DeepooBelief/BoostPFC/(list of files, cad)

Other CAD files:
software/adc_ex10_multiple_soc_epwm/CPU1_LAUNCHXL_FLASH/DCL_futils.obj
software/adc_ex10_multiple_soc_epwm/CPU1_LAUNCHXL_RAM/adc_ex10_multiple_soc_epwm.obj
software/adc_ex10_multiple_soc_epwm/CPU1_LAUNCHXL_RAM/device/device.obj
software/adc_ex10_multiple_soc_epwm/CPU1_LAUNCHXL_RAM/syscfg/c2000ware_libraries.obj
software/adc_ex10_multiple_soc_epwm/CPU1_RAM/adc_ex10_multiple_soc_epwm.obj
software/adc_ex10_multiple_soc_epwm/CPU1_RAM/syscfg/c2000ware_libraries.obj
software/adc_ex10_multiple_soc_epwm/CPU1_LAUNCHXL_FLASH/DCL_error.obj
software/adc_ex10_multiple_soc_epwm/CPU1_LAUNCHXL_RAM/syscfg/board.obj
software/adc_ex10_multiple_soc_epwm/CPU1_RAM/device/device.obj
software/adc_ex10_multiple_soc_epwm/CPU1_RAM/syscfg/board.obj
software/adc_ex10_multiple_soc_epwm/CPU1_LAUNCHXL_FLASH/DCL_PI_C1.obj
software/adc_ex10_multiple_soc_epwm/CPU1_LAUNCHXL_FLASH/DCL_PI_C7.obj
software/adc_ex10_multiple_soc_epwm/CPU1_LAUNCHXL_FLASH/DCL_PI_C4.obj
software/adc_ex10_multiple_soc_epwm/CPU1_LAUNCHXL_FLASH/DCL_DF23_C1.obj
software/adc_ex10_multiple_soc_epwm/CPU1_LAUNCHXL_FLASH/DCL_DF11_C1.obj
software/adc_ex10_multiple_soc_epwm/CPU1_LAUNCHXL_FLASH/DCL_DF13_C2C3.obj
software/adc_ex10_multiple_soc_epwm/CPU1_LAUNCHXL_FLASH/DCL_DF13_C1.obj
software/adc_ex10_multiple_soc_epwm/CPU1_LAUNCHXL_FLASH/DCL_PID_C4.obj
software/adc_ex10_multiple_soc_epwm/CPU1_LAUNCHXL_FLASH/DCL_clamp_C1.obj
software/adc_ex10_multiple_soc_epwm/CPU1_LAUNCHXL_FLASH/DCL_PID_C1.obj
software/adc_ex10_multiple_soc_epwm/CPU1_LAUNCHXL_FLASH/DCL_DF22_C1.obj
software/adc_ex10_multiple_soc_epwm/CPU1_LAUNCHXL_FLASH/DCL_DF22_C2C3.obj
software/adc_ex10_multiple_soc_epwm/CPU1_LAUNCHXL_FLASH/DCL_DF23_C2C3.obj
software/adc_ex10_multiple_soc_epwm/CPU1_LAUNCHXL_RAM/device/f28002x_codestartbranch.obj
software/adc_ex10_multiple_soc_epwm/CPU1_RAM/device/f28002x_codestartbranch.obj
