DeepooBelief/BoostPFC/hardware/SCH_Schematic1.pdf

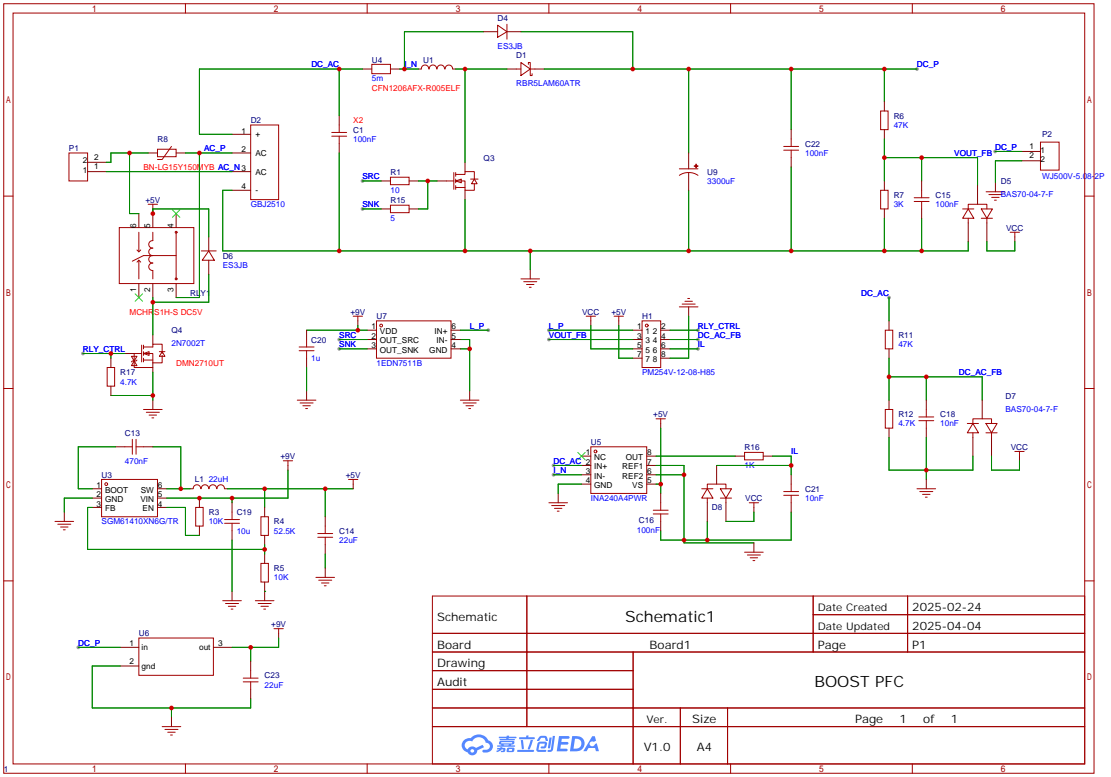
[picture p4: page 1]

Schematic | Schematic1 | Date Created | 2025-02-24

Date Updated | 2025-04-04

Board | Board1 | Page | P1
Drawing | | BOOST PFC
Audit

Ver. | Size | Page 1 of 1
