DeepooBelief/BoostPFC/hardware/PCB_PCB1.pdf

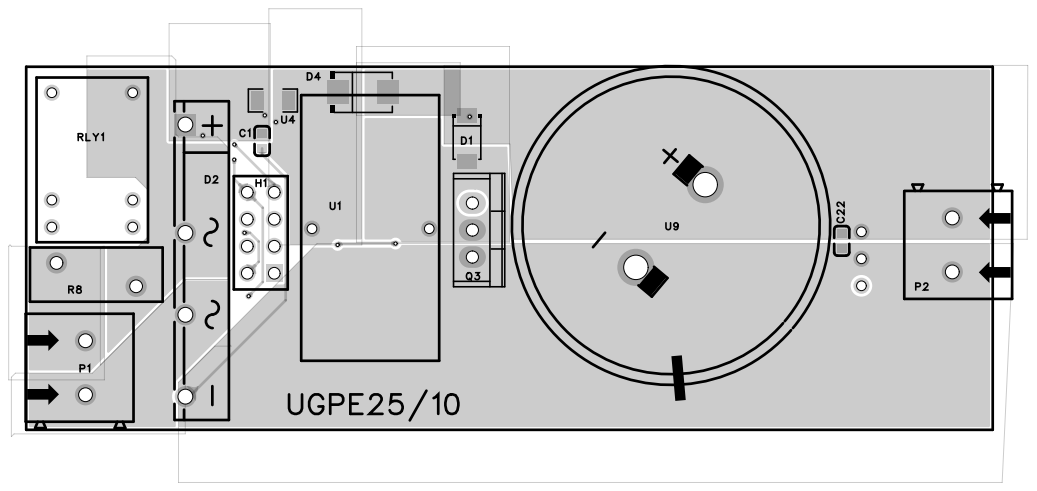
[picture p5: page 1]

RLY1

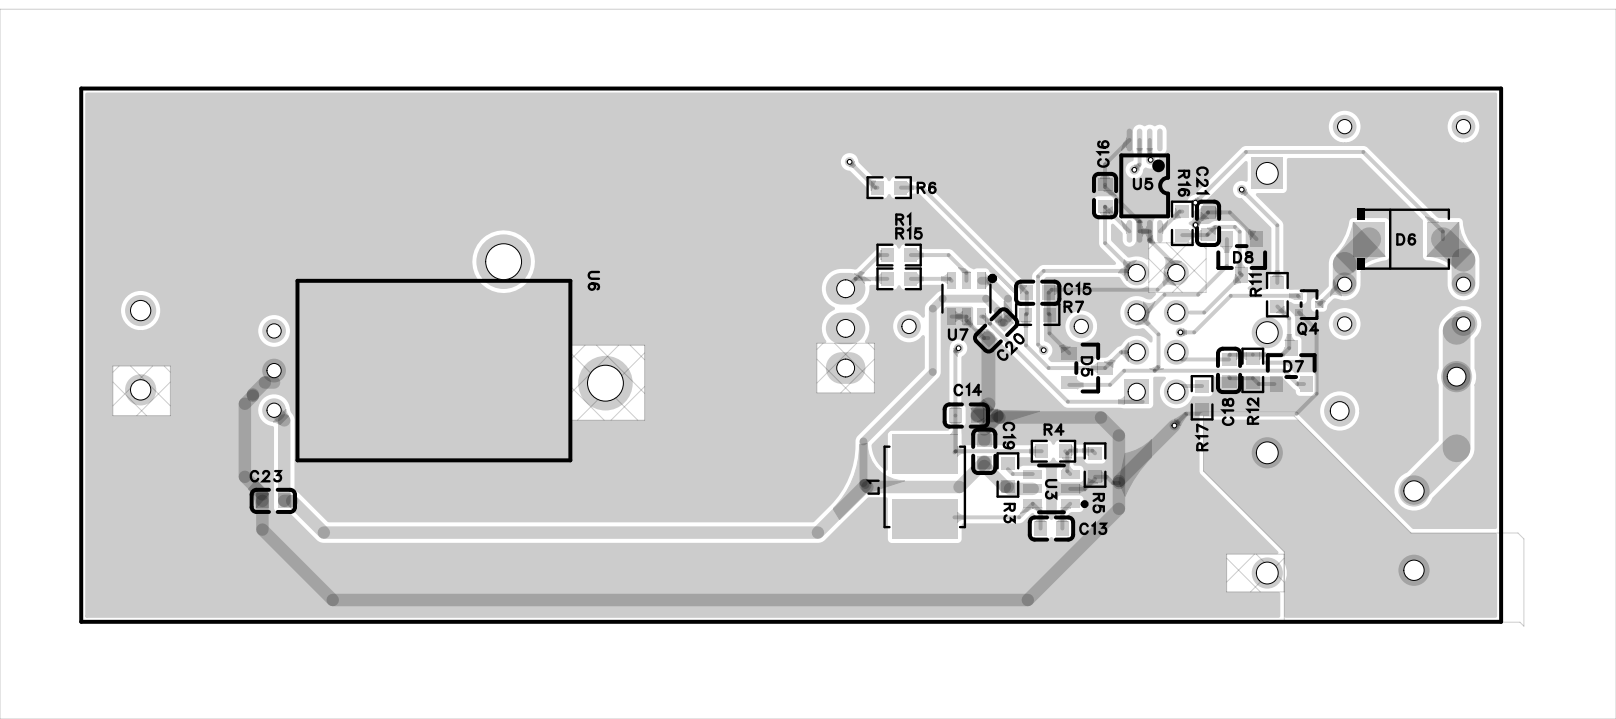
[picture p6: page 2]

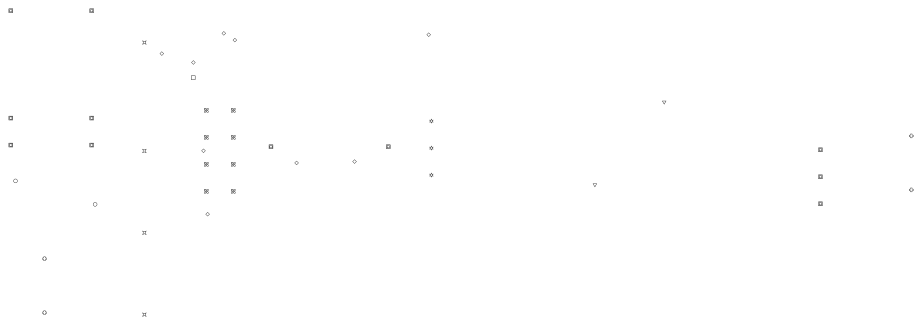
[picture p7: page 3]
