DeepooBelief/BoostPFC/simulation/ltspice/CCM-PFC(Switchless).asc

B1: bv; V=I(L1)
C1: cap; 0.1µ; V=50 Irms=0 Rser=0.07
C2: polcap; 1500µ; V=50 Irms=5.216 Rser=0.0246
C3: polcap; 1500µ; V=50 Irms=5.216 Rser=0.0246
D1: diode; DRBR5LAM60ATF
D2: diode
D3: diode
D4: diode
D5: diode
L1: ind; 470µ; Ipk=3 Rser=0.11 Rpar=9050 Cpar=55.774p
R1: res; 40
U1: UnitDelay; T=2e-5
U2: IPP052N08N5_L0
U3: UnitDelay; T=2e-5
U4: Proportional; K=0.1795
U5: add
U6: Proportional; K=5.6400e-05
U7: add
U8: sub
U9: limit; y=-4 z=4
U10: limit; y=0 z=4
U11: Proportional; K=0.1817
U12: sub
U13: add
U14: Proportional; K=0.0824
U15: mul
U16: add
U17: UnitDelay; T=2e-5
U18: limit; y=-100 z=100
U19: Proportional; K=1/(24*sqrt(2))
U20: limit; y=0 z=1
U21: UnitDelay; T=2e-5
U22: PWM; Vin1=0 Vin2=1 Tperiod=2e-5
U24: mul
V1: voltage; SINE(0 {24*sqrt(2)} 50)
V2: voltage; 10
V3: voltage; 40
Named nets: 0, AC_L, DC_P, AC_N, v*, ia*, DC_AC, m*, il, il*
.tran 0 500m 0 startup
.model SW SW(Ron=1 Roff=1Meg Vt=0.5)
.model D D(Ron=.1 Roff=1Meg Vfwd=.4)
Controller
Circuit
.ic V(DC_P)=0
voltage controller
current controller
Config
CCM-PFC
Continuous Conduction Mode Power Factor Correction
NOTE
Switching elements are approximated
by imaginary variable dc transformers.
This reduces transient analysis time.
Discontinuous conduction mode is NOT considered.
.MODEL DRBR5LAM60ATF D
+ IS=648.10E-9
+ N=.94915
+ RS=16.414E-3
+ IKF=1.8382
+ XTI=2
+ EG=.69
+ CJO=839.22E-12
+ M=.53961
+ VJ=.50407
+ ISR=6.2071E-6
+ NR=1.2000
+ BV=60
+ TRS1=0.0060
