DeepooBelief/BoostPFC/simulation/ltspice/CCM-PFC(Switchless)_REAL.asc

B1: bv; V=I(L1)
C1: cap; 1µ
C2: cap; 3300µ
D2: diode
D3: diode
D4: diode
D5: diode
D6: schottky; RBR20NS60A
L1: ind; 330µ
R1: res; 40
U1: UnitDelay; T=2e-5
U2: PWM; Vin1=0 Vin2=1 Tperiod=2e-5
U3: UnitDelay; T=2e-5
U4: Proportional; K=0.1095
U5: add
U6: Proportional; K=8.6000e-05
U7: add
U8: sub
U9: limit; y=-4 z=4
U10: limit; y=0 z=4
U11: Proportional; K=0.1095
U12: sub
U13: add
U14: Proportional; K=0.0540
U15: mul
U16: add
U17: UnitDelay; T=2e-5
U18: limit; y=-100 z=100
U19: Proportional; K=1/(24*sqrt(2))
U20: limit; y=0 z=1
U21: UnitDelay; T=2e-5
U22: IPA052N08NM5S_L0
U23: mul
V1: voltage; SINE(0 {24*sqrt(2)} 50)
V2: voltage; 10
V3: voltage; 40
Named nets: 0, AC_L, DC_P, AC_N, v*, ia*, DC_AC, m*, il, il*, PWM
.tran 0 500m 0 startup
.model SW SW(Ron=1 Roff=1Meg Vt=0.5)
.model D D(Ron=.1 Roff=1Meg Vfwd=.4)
Controller
Circuit
.ic V(DC_P)=0
voltage controller
current controller
Config
CCM-PFC
Continuous Conduction Mode Power Factor Correction
NOTE
Switching elements are approximated
by imaginary variable dc transformers.
This reduces transient analysis time.
Discontinuous conduction mode is NOT considered.
.MODEL DRBR5LAM60ATF D
+ IS=648.10E-9
+ N=.94915
+ RS=16.414E-3
+ IKF=1.8382
+ XTI=2
+ EG=.69
+ CJO=839.22E-12
+ M=.53961
+ VJ=.50407
+ ISR=6.2071E-6
+ NR=1.2000
+ BV=60
+ TRS1=0.0060
