DeepooBelief/BoostPFC/simulation/ltspice/DCDCboost_Ideal.asc

C1: cap; 3.3m
D1: diode
I1: current; {Iout}
L1: ind; 330µ
S1: sw
V1: voltage; {Vsupp}
V2: voltage; PULSE(0 9 0 0.000000008 0.000000008 {duty*0.00002} 0.00002)
Named nets: 0, PWM, Vout, Vin
.MODEL SW SW(Ron=0.0001 Roff=10Meg Vt=.5 Vh=0)
.tran 2
.ic V(Vout)=39.3 I(L1)={ILinit}
.param ILinit=39.3/Vsupp
.param Vsupp=24 duty=1-Vsupp/40
.param Iout 1
.meas TRAN PIN AVG (-V(Vin)*I(V1)) FROM 1999.84ms TO 1999.98ms
.meas TRAN POUT AVG (V(Vout)*I(I1)) FROM 1999.84ms TO 1999.98ms
.meas TRAN V_ripple PP V(Vout) FROM 1999.84ms TO 1999.98ms
.meas TRAN Vfinal AVG (V(vout)) FROM 1999.84ms TO 1999.98ms
.meas TRAN eff PARAM POUT/PIN
.meas TRAN I_ripple PP I(L1) FROM 1999.84ms TO 1999.98ms
.meas TRAN V_peak MAX V(Vout)
.meas TRAN Overshoot PARAM (V_peak-Vfinal)/Vfinal
.ic V(Vout)=0 I(L1)=0
.meas TRAN v_90 FIND time WHEN V(Vout)=0.9*{Vfinal} RISE=1
.meas TRAN v_10 FIND time WHEN V(Vout)=0.1*{Vfinal} RISE=1
.meas TRAN rise_time PARAM v_90-v_10
.meas TRAN tsettle FIND time WHEN abs(V(Vout) - {Vfinal})=0.02*abs({Vfinal}) RISE=LAST
