DeepooBelief/BoostPFC/software/adc_ex10_multiple_soc_epwm/CPU1_LAUNCHXL_RAM/syscfg/board.c

/*
 * Copyright (c) 2020 Texas Instruments Incorporated - http://www.ti.com
 * All rights reserved.
 *
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
 * *  Redistributions of source code must retain the above copyright
 *    notice, this list of conditions and the following disclaimer.
 *
 * *  Redistributions in binary form must reproduce the above copyright
 *    notice, this list of conditions and the following disclaimer in the
 *    documentation and/or other materials provided with the distribution.
 *
 * *  Neither the name of Texas Instruments Incorporated nor the names of
 *    its contributors may be used to endorse or promote products derived
 *    from this software without specific prior written permission.
 *
 * THIS SOFTWARE IS PROVIDED BY THE COPYRIGHT HOLDERS AND CONTRIBUTORS "AS IS"
 * AND ANY EXPRESS OR IMPLIED WARRANTIES, INCLUDING, BUT NOT LIMITED TO,
 * THE IMPLIED WARRANTIES OF MERCHANTABILITY AND FITNESS FOR A PARTICULAR
 * PURPOSE ARE DISCLAIMED. IN NO EVENT SHALL THE COPYRIGHT OWNER OR
 * CONTRIBUTORS BE LIABLE FOR ANY DIRECT, INDIRECT, INCIDENTAL, SPECIAL,
 * EXEMPLARY, OR CONSEQUENTIAL DAMAGES (INCLUDING, BUT NOT LIMITED TO,
 * PROCUREMENT OF SUBSTITUTE GOODS OR SERVICES; LOSS OF USE, DATA, OR PROFITS;
 * OR BUSINESS INTERRUPTION) HOWEVER CAUSED AND ON ANY THEORY OF LIABILITY,
 * WHETHER IN CONTRACT, STRICT LIABILITY, OR TORT (INCLUDING NEGLIGENCE OR
 * OTHERWISE) ARISING IN ANY WAY OUT OF THE USE OF THIS SOFTWARE,
 * EVEN IF ADVISED OF THE POSSIBILITY OF SUCH DAMAGE.
 *
 */

#include "board.h"

//*****************************************************************************
//
// Board Configurations
// Initializes the rest of the modules. 
// Call this function in your application if you wish to do all module 
// initialization.
// If you wish to not use some of the initializations, instead of the 
// Board_init use the individual Module_inits
//
//*****************************************************************************
void Board_init()
{
	EALLOW;

	PinMux_init();
	ASYSCTL_init();
	ADC_init();
	SCI_init();
	INTERRUPT_init();

	EDIS;
}

//*****************************************************************************
//
// PINMUX Configurations
//
//*****************************************************************************
void PinMux_init()
{
	//
	// PinMux for modules assigned to CPU1
	//
	
	//
	// ANALOG -> myANALOGPinMux0 Pinmux
	//
	// Analog PinMux for A0/C15
	GPIO_setPinConfig(GPIO_231_GPIO231);
	// AIO -> Analog mode selected
	GPIO_setAnalogMode(231, GPIO_ANALOG_ENABLED);
	// Analog PinMux for A1
	GPIO_setPinConfig(GPIO_232_GPIO232);
	// AIO -> Analog mode selected
	GPIO_setAnalogMode(232, GPIO_ANALOG_ENABLED);
	// Analog PinMux for A10/C10
	GPIO_setPinConfig(GPIO_230_GPIO230);
	// AIO -> Analog mode selected
	GPIO_setAnalogMode(230, GPIO_ANALOG_ENABLED);
	// Analog PinMux for A11/C0
	GPIO_setPinConfig(GPIO_237_GPIO237);
	// AIO -> Analog mode selected
	GPIO_setAnalogMode(237, GPIO_ANALOG_ENABLED);
	// Analog PinMux for A12/C1
	GPIO_setPinConfig(GPIO_238_GPIO238);
	// AIO -> Analog mode selected
	GPIO_setAnalogMode(238, GPIO_ANALOG_ENABLED);
	// Analog PinMux for A14/C4
	GPIO_setPinConfig(GPIO_239_GPIO239);
	// AIO -> Analog mode selected
	GPIO_setAnalogMode(239, GPIO_ANALOG_ENABLED);
	// Analog PinMux for A15/C7
	GPIO_setPinConfig(GPIO_233_GPIO233);
	// AIO -> Analog mode selected
	GPIO_setAnalogMode(233, GPIO_ANALOG_ENABLED);
	// Analog PinMux for A2/C9
	GPIO_setPinConfig(GPIO_224_GPIO224);
	// AIO -> Analog mode selected
	GPIO_setAnalogMode(224, GPIO_ANALOG_ENABLED);
	// Analog PinMux for A3/C5/VDAC
	GPIO_setPinConfig(GPIO_242_GPIO242);
	// AIO -> Analog mode selected
	GPIO_setAnalogMode(242, GPIO_ANALOG_ENABLED);
	// Analog PinMux for A4/C14
	GPIO_setPinConfig(GPIO_225_GPIO225);
	// AIO -> Analog mode selected
	GPIO_setAnalogMode(225, GPIO_ANALOG_ENABLED);
	// Analog PinMux for A5/C2
	GPIO_setPinConfig(GPIO_244_GPIO244);
	// AIO -> Analog mode selected
	GPIO_setAnalogMode(244, GPIO_ANALOG_ENABLED);
	// Analog PinMux for A6
	GPIO_setPinConfig(GPIO_228_GPIO228);
	// AIO -> Analog mode selected
	GPIO_setAnalogMode(228, GPIO_ANALOG_ENABLED);
	// Analog PinMux for A7/C3
	GPIO_setPinConfig(GPIO_245_GPIO245);
	// AIO -> Analog mode selected
	GPIO_setAnalogMode(245, GPIO_ANALOG_ENABLED);
	// Analog PinMux for A8/C11
	GPIO_setPinConfig(GPIO_241_GPIO241);
	// AIO -> Analog mode selected
	GPIO_setAnalogMode(241, GPIO_ANALOG_ENABLED);
	// Analog PinMux for A9/C8
	GPIO_setPinConfig(GPIO_227_GPIO227);
	// AIO -> Analog mode selected
	GPIO_setAnalogMode(227, GPIO_ANALOG_ENABLED);
	// Analog PinMux for C6
	GPIO_setPinConfig(GPIO_226_GPIO226);
	// AIO -> Analog mode selected
	GPIO_setAnalogMode(226, GPIO_ANALOG_ENABLED);
	//
	// SCIA -> mySCI0 Pinmux
	//
	GPIO_setPinConfig(mySCI0_SCIRX_PIN_CONFIG);
	GPIO_setPadConfig(mySCI0_SCIRX_GPIO, GPIO_PIN_TYPE_STD | GPIO_PIN_TYPE_PULLUP);
	GPIO_setQualificationMode(mySCI0_SCIRX_GPIO, GPIO_QUAL_ASYNC);

	GPIO_setPinConfig(mySCI0_SCITX_PIN_CONFIG);
	GPIO_setPadConfig(mySCI0_SCITX_GPIO, GPIO_PIN_TYPE_STD | GPIO_PIN_TYPE_PULLUP);
	GPIO_setQualificationMode(mySCI0_SCITX_GPIO, GPIO_QUAL_ASYNC);


}

//*****************************************************************************
//
// ADC Configurations
//
//*****************************************************************************
void ADC_init(){
	myADC0_init();
	myADC1_init();
}

void myADC0_init(){
	//
	// ADC Initialization: Write ADC configurations and power up the ADC
	//
	// Set the analog voltage reference selection and ADC module's offset trims.
	// This function sets the analog voltage reference to internal (with the reference voltage of 1.65V or 2.5V) or external for ADC
	// which is same as ASysCtl APIs.
	//
	ADC_setVREF(myADC0_BASE, ADC_REFERENCE_INTERNAL, ADC_REFERENCE_3_3V);
	//
	// Configures the analog-to-digital converter module prescaler.
	//
	ADC_setPrescaler(myADC0_BASE, ADC_CLK_DIV_2_0);
	//
	// Sets the timing of the end-of-conversion pulse
	//
	ADC_setInterruptPulseMode(myADC0_BASE, ADC_PULSE_END_OF_CONV);
	//
	// Powers up the analog-to-digital converter core.
	//
	ADC_enableConverter(myADC0_BASE);
	//
	// Delay for 1ms to allow ADC time to power up
	//
	DEVICE_DELAY_US(5000);
	//
	// SOC Configuration: Setup ADC EPWM channel and trigger settings
	//
	// Disables SOC burst mode.
	//
	ADC_disableBurstMode(myADC0_BASE);
	//
	// Sets the priority mode of the SOCs.
	//
	ADC_setSOCPriority(myADC0_BASE, ADC_PRI_ALL_ROUND_ROBIN);
	//
	// Start of Conversion 0 Configuration
	//
	//
	// Configures a start-of-conversion (SOC) in the ADC and its interrupt SOC trigger.
	// 	  	SOC number		: 0
	//	  	Trigger			: ADC_TRIGGER_EPWM1_SOCA
	//	  	Channel			: ADC_CH_ADCIN0
	//	 	Sample Window	: 8 SYSCLK cycles
	//		Interrupt Trigger: ADC_INT_SOC_TRIGGER_NONE
	//
	ADC_setupSOC(myADC0_BASE, ADC_SOC_NUMBER0, ADC_TRIGGER_EPWM1_SOCA, ADC_CH_ADCIN0, 8U);
	ADC_setInterruptSOCTrigger(myADC0_BASE, ADC_SOC_NUMBER0, ADC_INT_SOC_TRIGGER_NONE);
	//
	// Start of Conversion 1 Configuration
	//
	//
	// Configures a start-of-conversion (SOC) in the ADC and its interrupt SOC trigger.
	// 	  	SOC number		: 1
	//	  	Trigger			: ADC_TRIGGER_EPWM1_SOCA
	//	  	Channel			: ADC_CH_ADCIN1
	//	 	Sample Window	: 8 SYSCLK cycles
	//		Interrupt Trigger: ADC_INT_SOC_TRIGGER_NONE
	//
	ADC_setupSOC(myADC0_BASE, ADC_SOC_NUMBER1, ADC_TRIGGER_EPWM1_SOCA, ADC_CH_ADCIN1, 8U);
	ADC_setInterruptSOCTrigger(myADC0_BASE, ADC_SOC_NUMBER1, ADC_INT_SOC_TRIGGER_NONE);
	//
	// Start of Conversion 2 Configuration
	//
	//
	// Configures a start-of-conversion (SOC) in the ADC and its interrupt SOC trigger.
	// 	  	SOC number		: 2
	//	  	Trigger			: ADC_TRIGGER_EPWM1_SOCA
	//	  	Channel			: ADC_CH_ADCIN2
	//	 	Sample Window	: 8 SYSCLK cycles
	//		Interrupt Trigger: ADC_INT_SOC_TRIGGER_NONE
	//
	ADC_setupSOC(myADC0_BASE, ADC_SOC_NUMBER2, ADC_TRIGGER_EPWM1_SOCA, ADC_CH_ADCIN2, 8U);
	ADC_setInterruptSOCTrigger(myADC0_BASE, ADC_SOC_NUMBER2, ADC_INT_SOC_TRIGGER_NONE);
	//
	// ADC Interrupt 1 Configuration
	// 		Source	: ADC_SOC_NUMBER2
	// 		Interrupt Source: enabled
	// 		Continuous Mode	: disabled
	//
	//
	ADC_setInterruptSource(myADC0_BASE, ADC_INT_NUMBER1, ADC_SOC_NUMBER2);
	ADC_clearInterruptStatus(myADC0_BASE, ADC_INT_NUMBER1);
	ADC_disableContinuousMode(myADC0_BASE, ADC_INT_NUMBER1);
	ADC_enableInterrupt(myADC0_BASE, ADC_INT_NUMBER1);
}

void myADC1_init(){
	//
	// ADC Initialization: Write ADC configurations and power up the ADC
	//
	// Set the analog voltage reference selection and ADC module's offset trims.
	// This function sets the analog voltage reference to internal (with the reference voltage of 1.65V or 2.5V) or external for ADC
	// which is same as ASysCtl APIs.
	//
	ADC_setVREF(myADC1_BASE, ADC_REFERENCE_INTERNAL, ADC_REFERENCE_3_3V);
	//
	// Configures the analog-to-digital converter module prescaler.
	//
	ADC_setPrescaler(myADC1_BASE, ADC_CLK_DIV_2_0);
	//
	// Sets the timing of the end-of-conversion pulse
	//
	ADC_setInterruptPulseMode(myADC1_BASE, ADC_PULSE_END_OF_CONV);
	//
	// Powers up the analog-to-digital converter core.
	//
	ADC_enableConverter(myADC1_BASE);
	//
	// Delay for 1ms to allow ADC time to power up
	//
	DEVICE_DELAY_US(5000);
	//
	// SOC Configuration: Setup ADC EPWM channel and trigger settings
	//
	// Disables SOC burst mode.
	//
	ADC_disableBurstMode(myADC1_BASE);
	//
	// Sets the priority mode of the SOCs.
	//
	ADC_setSOCPriority(myADC1_BASE, ADC_PRI_ALL_ROUND_ROBIN);
	//
	// Start of Conversion 0 Configuration
	//
	//
	// Configures a start-of-conversion (SOC) in the ADC and its interrupt SOC trigger.
	// 	  	SOC number		: 0
	//	  	Trigger			: ADC_TRIGGER_EPWM1_SOCA
	//	  	Channel			: ADC_CH_ADCIN2
	//	 	Sample Window	: 8 SYSCLK cycles
	//		Interrupt Trigger: ADC_INT_SOC_TRIGGER_NONE
	//
	ADC_setupSOC(myADC1_BASE, ADC_SOC_NUMBER0, ADC_TRIGGER_EPWM1_SOCA, ADC_CH_ADCIN2, 8U);
	ADC_setInterruptSOCTrigger(myADC1_BASE, ADC_SOC_NUMBER0, ADC_INT_SOC_TRIGGER_NONE);
	//
	// Start of Conversion 1 Configuration
	//
	//
	// Configures a start-of-conversion (SOC) in the ADC and its interrupt SOC trigger.
	// 	  	SOC number		: 1
	//	  	Trigger			: ADC_TRIGGER_EPWM1_SOCA
	//	  	Channel			: ADC_CH_ADCIN3
	//	 	Sample Window	: 8 SYSCLK cycles
	//		Interrupt Trigger: ADC_INT_SOC_TRIGGER_NONE
	//
	ADC_setupSOC(myADC1_BASE, ADC_SOC_NUMBER1, ADC_TRIGGER_EPWM1_SOCA, ADC_CH_ADCIN3, 8U);
	ADC_setInterruptSOCTrigger(myADC1_BASE, ADC_SOC_NUMBER1, ADC_INT_SOC_TRIGGER_NONE);
	//
	// Start of Conversion 2 Configuration
	//
	//
	// Configures a start-of-conversion (SOC) in the ADC and its interrupt SOC trigger.
	// 	  	SOC number		: 2
	//	  	Trigger			: ADC_TRIGGER_EPWM1_SOCA
	//	  	Channel			: ADC_CH_ADCIN4
	//	 	Sample Window	: 8 SYSCLK cycles
	//		Interrupt Trigger: ADC_INT_SOC_TRIGGER_NONE
	//
	ADC_setupSOC(myADC1_BASE, ADC_SOC_NUMBER2, ADC_TRIGGER_EPWM1_SOCA, ADC_CH_ADCIN4, 8U);
	ADC_setInterruptSOCTrigger(myADC1_BASE, ADC_SOC_NUMBER2, ADC_INT_SOC_TRIGGER_NONE);
}


//*****************************************************************************
//
// ASYSCTL Configurations
//
//*****************************************************************************
void ASYSCTL_init(){
	//
	// asysctl initialization
	//
	// Disables the temperature sensor output to the ADC.
	//
	ASysCtl_disableTemperatureSensor();
	//
	// Set the analog voltage reference selection to internal.
	//
	ASysCtl_setAnalogReferenceInternal( ASYSCTL_VREFHIA | ASYSCTL_VREFHIC );
	//
	// Set the internal analog voltage reference selection to 1.65V.
	//
	ASysCtl_setAnalogReference1P65( ASYSCTL_VREFHIA | ASYSCTL_VREFHIC );
}

//*****************************************************************************
//
// INTERRUPT Configurations
//
//*****************************************************************************
void INTERRUPT_init(){
	
	// Interrupt Settings for INT_myADC0_1
	// ISR need to be defined for the registered interrupts
	Interrupt_register(INT_myADC0_1, &adcA1ISR);
	Interrupt_enable(INT_myADC0_1);
}
//*****************************************************************************
//
// SCI Configurations
//
//*****************************************************************************
void SCI_init(){
	mySCI0_init();
}

void mySCI0_init(){
	SCI_clearInterruptStatus(mySCI0_BASE, SCI_INT_RXFF | SCI_INT_TXFF | SCI_INT_FE | SCI_INT_OE | SCI_INT_PE | SCI_INT_RXERR | SCI_INT_RXRDY_BRKDT | SCI_INT_TXRDY);
	SCI_clearOverflowStatus(mySCI0_BASE);
	SCI_resetTxFIFO(mySCI0_BASE);
	SCI_resetRxFIFO(mySCI0_BASE);
	SCI_resetChannels(mySCI0_BASE);
	SCI_setConfig(mySCI0_BASE, DEVICE_LSPCLK_FREQ, mySCI0_BAUDRATE, (SCI_CONFIG_WLEN_8|SCI_CONFIG_STOP_ONE|SCI_CONFIG_PAR_NONE));
	SCI_disableLoopback(mySCI0_BASE);
	SCI_performSoftwareReset(mySCI0_BASE);
	SCI_setFIFOInterruptLevel(mySCI0_BASE, SCI_FIFO_TX0, SCI_FIFO_RX0);
	SCI_enableFIFO(mySCI0_BASE);
	SCI_enableModule(mySCI0_BASE);
}
