DeepooBelief/BoostPFC/(notices)

Notices in the files:
software/adc_ex10_multiple_soc_epwm/adc_ex10_multiple_soc_epwm.c:
Copyright (C) 2024 Texas Instruments Incorporated - http://www.ti.com
